gudzpoz/keypaw48/paw.png

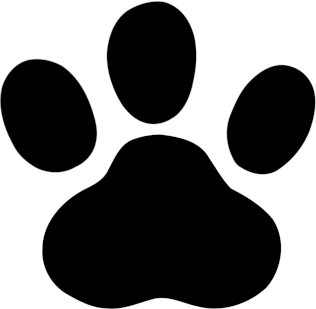
paw.png
