gudzpoz/keypaw48/keypaw48lr/keypaw48lr.kicad_pcb

## KiCad design keypaw48lr/keypaw48lr.kicad_pcb (2026-08-05)

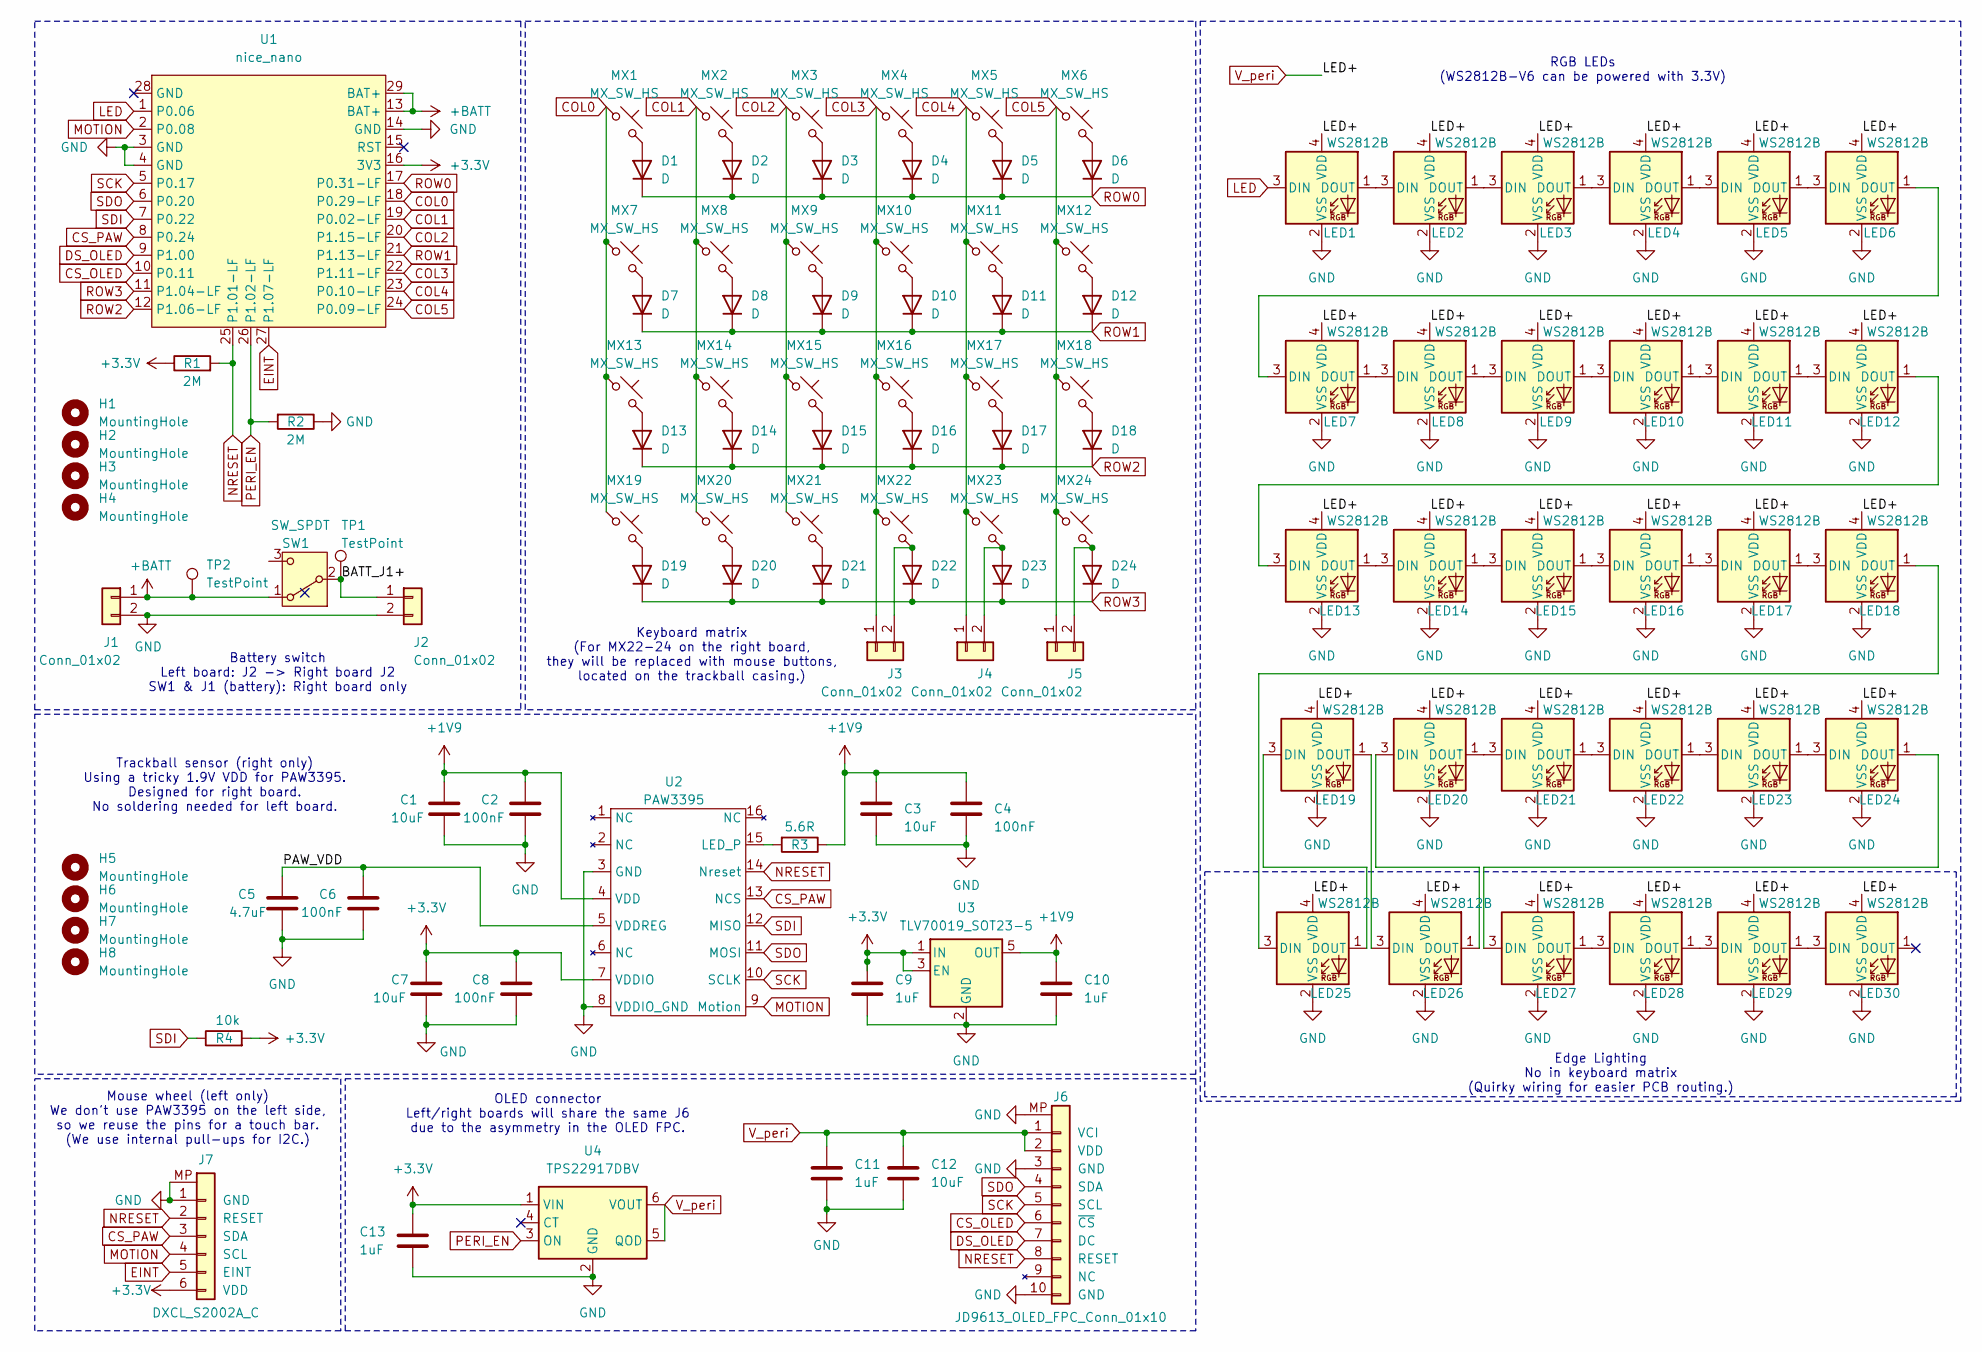
[picture p2: schematic keypaw48lr.kicad_sch, Keypaw48 Schematic (Left & Right Board)]

Parts:
C1, C3, C7, C12: 10uF; C_1206_3216Metric_Pad1.33x1.80mm_HandSolder
C2, C4, C6, C8: 100nF; C_0805_2012Metric_Pad1.18x1.45mm_HandSolder
C5: 4.7uF; C_1206_3216Metric_Pad1.33x1.80mm_HandSolder
C9, C10, C11: 1uF; C_1206_3216Metric_Pad1.33x1.80mm_HandSolder
C13: 1uF; C_1206_3216Metric_Pad1.33x1.80mm_HandSolder_REV
D1, D2, D3, D4, D5, D6, D7, D8, D9, D10, D11, D12, D13, D14, D15, D16, D17, D18, D19, D20, D21, D22, D23, D24: D; D_SOD-123_REV
H1, H2, H3, H4, H5, H6, H7, H8: MountingHole; MountingHole_2.2mm_M2_DIN965_Pad_TopBottom
J1: Conn_01x02; Conn_1x02_P1.25mm_Horizontal_Battery_REV
J2: Conn_01x02; Conn_1x02_P1.25mm_Horizontal_Battery
J3, J4, J5: Conn_01x02; Molex_PicoBlade_53048-0210_1x02_P1.25mm_Horizontal
J6: JD9613_OLED_FPC_Conn_01x10; FH34SRJ-10S-0.5SH
J7: DXCL_S2002A_C; FH34SRJ-10S-0.5SH
LED1, LED2, LED3, LED4, LED5, LED6, LED7, LED8, LED9, LED10, LED11, LED12, LED13, LED14, LED15, LED16, LED17, LED18, LED19, LED20, LED21, LED22, LED23, LED24, LED25, LED26, LED27, LED28, LED29, LED30: WS2812B; LED_WS2812B-2020_backmount_rev
MX1, MX2, MX3, MX4, MX5, MX6, MX7, MX8, MX9, MX10, MX11, MX12, MX13, MX14, MX15, MX16, MX17, MX18, MX19, MX20, MX21, MX22, MX23, MX24: MX_SW_HS; SW_MX_HS_REV
R1, R2: 2M; R_1206_3216Metric_Pad1.30x1.75mm_HandSolder
R3: 5.6R; R_1206_3216Metric_Pad1.30x1.75mm_HandSolder
R4: 10k; R_1206_3216Metric_Pad1.30x1.75mm_HandSolder
SW1: SW_SPDT; SW_SPDT_CK_JS102011SAQN
TP1, TP2: TestPoint; TestPoint_THTPad_D2.0mm_Drill1.0mm_nosilk
U1: nice_nano; nice_nano_AH_USBup_REV
U2: PAW3395
U3: TLV70019_SOT23-5; SOT-23-5_HandSoldering
U4: TPS22917DBV; SOT-23-6_Handsoldering_REV

Connections:
+1V9: C1.1, C2.1, C3.1, C4.1, C10.1, R3.1, U2.4 (VDD), U3.5 (OUT)
+3.3V: C7.1, C8.1, C9.1, C13.1, J7.6 (VDD), R1.1, R4.2, U1.16 (3V3), U2.7 (VDDIO), U3.1 (IN), U3.3 (EN), U4.1 (VIN)
+BATT: J1.1, SW1.1 (A), TP2.1 (1_1), U1.13 (BAT+), U1.29 (BAT+)
/BATT_J1+: J2.1, SW1.2 (B), TP1.1 (1_1)
/PAW_VDD: C5.1, C6.1, U2.5 (VDDREG)
COL0: MX1.1, MX7.1, MX13.1, MX19.1, U1.18 (P0.29-LF)
COL1: MX2.1, MX8.1, MX14.1, MX20.1, U1.19 (P0.02-LF)
COL2: MX3.1, MX9.1, MX15.1, MX21.1, U1.20 (P1.15-LF)
COL3: J3.1, MX4.1, MX10.1, MX16.1, MX22.1, U1.22 (P1.11-LF)
COL4: J4.1, MX5.1, MX11.1, MX17.1, MX23.1, U1.23 (P0.10-LF)
COL5: J5.1, MX6.1, MX12.1, MX18.1, MX24.1, U1.24 (P0.09-LF)
CS_OLED: J6.6 (~CS), U1.10 (P0.11)
CS_PAW: J7.3 (SDA), U1.8 (P0.24), U2.13 (NCS)
DS_OLED: J6.7 (DC), U1.9 (P1.00)
EINT: J7.5 (EINT), U1.27 (P1.07-LF)
GND: C1.2, C2.2, C3.2, C4.2, C5.2, C6.2, C7.2, C8.2, C9.2, C10.2, C11.2, C12.2, C13.2, J1.2, J2.2, J6.3 (GND), J6.10 (GND), J6.MP, J7.1 (GND), J7.MP, LED1.2 (VSS), LED2.2 (VSS), LED3.2 (VSS), LED4.2 (VSS), LED5.2 (VSS), LED6.2 (VSS), LED7.2 (VSS), LED8.2 (VSS), LED9.2 (VSS), LED10.2 (VSS), LED11.2 (VSS), LED12.2 (VSS), LED13.2 (VSS), LED14.2 (VSS), LED15.2 (VSS), LED16.2 (VSS), LED17.2 (VSS), LED18.2 (VSS), LED19.2 (VSS), LED20.2 (VSS), LED21.2 (VSS), LED22.2 (VSS), LED23.2 (VSS), LED24.2 (VSS), LED25.2 (VSS), LED26.2 (VSS), LED27.2 (VSS), LED28.2 (VSS), LED29.2 (VSS), LED30.2 (VSS), R2.1, U1.3 (GND), U1.4 (GND), U1.14 (GND), U2.3 (GND), U2.8 (VDDIO_GND), U3.2 (GND), U4.2 (GND)
LED: LED1.3 (DIN), U1.1 (P0.06)
MOTION: J7.4 (SCL), U1.2 (P0.08), U2.9 (Motion)
NRESET: J6.8 (RESET), J7.2 (RESET), R1.2, U1.25 (P1.01-LF), U2.14 (Nreset)
unnamed: D1.2 (A), MX1.2
unnamed: D2.2 (A), MX2.2
unnamed: D3.2 (A), MX3.2
unnamed: D4.2 (A), MX4.2
unnamed: D5.2 (A), MX5.2
unnamed: D6.2 (A), MX6.2
unnamed: D7.2 (A), MX7.2
unnamed: D8.2 (A), MX8.2
unnamed: D9.2 (A), MX9.2
unnamed: D10.2 (A), MX10.2
unnamed: D11.2 (A), MX11.2
unnamed: D12.2 (A), MX12.2
unnamed: D13.2 (A), MX13.2
unnamed: D14.2 (A), MX14.2
unnamed: D15.2 (A), MX15.2
unnamed: D16.2 (A), MX16.2
unnamed: D17.2 (A), MX17.2
unnamed: D18.2 (A), MX18.2
unnamed: D19.2 (A), MX19.2
unnamed: D20.2 (A), MX20.2
unnamed: D21.2 (A), MX21.2
unnamed: D22.2 (A), J3.2, MX22.2
unnamed: D23.2 (A), J4.2, MX23.2
unnamed: D24.2 (A), J5.2, MX24.2
unnamed: LED1.1 (DOUT), LED2.3 (DIN)
unnamed: LED2.1 (DOUT), LED3.3 (DIN)
unnamed: LED3.1 (DOUT), LED4.3 (DIN)
unnamed: LED4.1 (DOUT), LED5.3 (DIN)
unnamed: LED5.1 (DOUT), LED6.3 (DIN)
unnamed: LED6.1 (DOUT), LED7.3 (DIN)
unnamed: LED7.1 (DOUT), LED8.3 (DIN)
unnamed: LED8.1 (DOUT), LED9.3 (DIN)
unnamed: LED9.1 (DOUT), LED10.3 (DIN)
unnamed: LED10.1 (DOUT), LED11.3 (DIN)
unnamed: LED11.1 (DOUT), LED12.3 (DIN)
unnamed: LED12.1 (DOUT), LED13.3 (DIN)
unnamed: LED13.1 (DOUT), LED14.3 (DIN)
unnamed: LED14.1 (DOUT), LED15.3 (DIN)
unnamed: LED15.1 (DOUT), LED16.3 (DIN)
unnamed: LED16.1 (DOUT), LED17.3 (DIN)
unnamed: LED17.1 (DOUT), LED18.3 (DIN)
unnamed: LED18.1 (DOUT), LED25.3 (DIN)
unnamed: LED19.3 (DIN), LED25.1 (DOUT)
unnamed: LED19.1 (DOUT), LED26.3 (DIN)
unnamed: LED20.3 (DIN), LED26.1 (DOUT)
unnamed: LED20.1 (DOUT), LED21.3 (DIN)
unnamed: LED21.1 (DOUT), LED22.3 (DIN)
unnamed: LED22.1 (DOUT), LED23.3 (DIN)
unnamed: LED23.1 (DOUT), LED24.3 (DIN)
unnamed: LED24.1 (DOUT), LED27.3 (DIN)
unnamed: LED27.1 (DOUT), LED28.3 (DIN)
unnamed: LED28.1 (DOUT), LED29.3 (DIN)
unnamed: LED29.1 (DOUT), LED30.3 (DIN)
unnamed: R3.2, U2.15 (LED_P)
PERI_EN: R2.2, U1.26 (P1.02-LF), U4.3 (ON)
ROW0: D1.1 (K), D2.1 (K), D3.1 (K), D4.1 (K), D5.1 (K), D6.1 (K), U1.17 (P0.31-LF)
ROW1: D7.1 (K), D8.1 (K), D9.1 (K), D10.1 (K), D11.1 (K), D12.1 (K), U1.21 (P1.13-LF)
ROW2: D13.1 (K), D14.1 (K), D15.1 (K), D16.1 (K), D17.1 (K), D18.1 (K), U1.12 (P1.06-LF)
ROW3: D19.1 (K), D20.1 (K), D21.1 (K), D22.1 (K), D23.1 (K), D24.1 (K), U1.11 (P1.04-LF)
SCK: J6.5 (SCL), U1.5 (P0.17), U2.10 (SCLK)
SDI: R4.1, U1.7 (P0.22), U2.12 (MISO)
SDO: J6.4 (SDA), U1.6 (P0.20), U2.11 (MOSI)
V_peri: C11.1, C12.1, J6.1 (VCI), J6.2 (VDD), LED1.4 (VDD), LED2.4 (VDD), LED3.4 (VDD), LED4.4 (VDD), LED5.4 (VDD), LED6.4 (VDD), LED7.4 (VDD), LED8.4 (VDD), LED9.4 (VDD), LED10.4 (VDD), LED11.4 (VDD), LED12.4 (VDD), LED13.4 (VDD), LED14.4 (VDD), LED15.4 (VDD), LED16.4 (VDD), LED17.4 (VDD), LED18.4 (VDD), LED19.4 (VDD), LED20.4 (VDD), LED21.4 (VDD), LED22.4 (VDD), LED23.4 (VDD), LED24.4 (VDD), LED25.4 (VDD), LED26.4 (VDD), LED27.4 (VDD), LED28.4 (VDD), LED29.4 (VDD), LED30.4 (VDD), U4.5 (QOD), U4.6 (VOUT)

Notes on the sheet:
Trackball sensor (right only) Using a tricky 1.9V VDD for PAW3395. Designed for right board. No soldering needed for left board.
Battery switch Left board: J2 -> Right board J2 SW1 & J1 (battery): Right board only
Mouse wheel (left only) We don't use PAW3395 on the left side, so we reuse the pins for a touch bar. (We use internal pull-ups for I2C.)
Edge Lighting No in keyboard matrix (Quirky wiring for easier PCB routing.)
OLED connector Left/right boards will share the same J6 due to the asymmetry in the OLED FPC.
Keyboard matrix (For MX22-24 on the right board, they will be replaced with mouse buttons, located on the trackball casing.)
RGB LEDs (WS2812B-V6 can be powered with 3.3V)

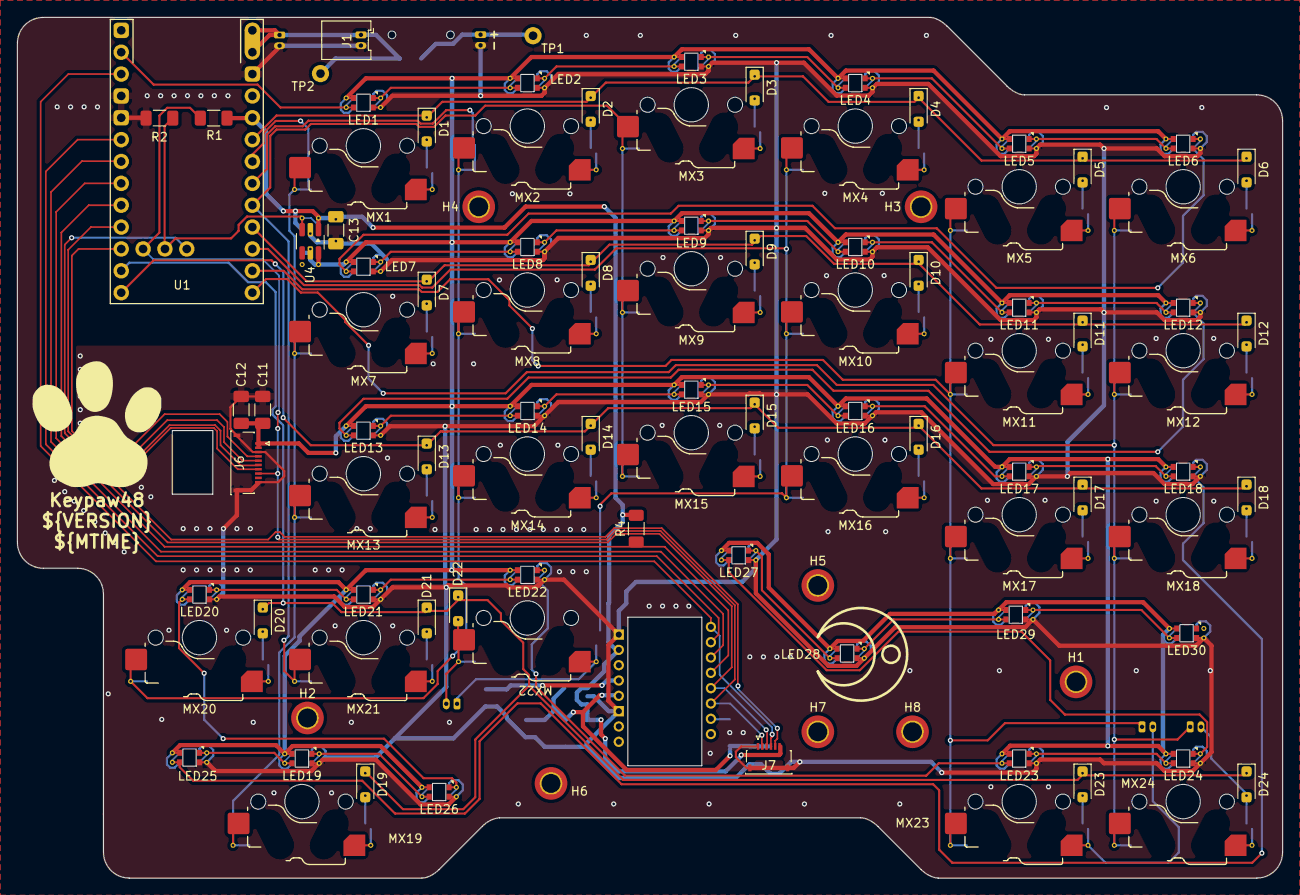
[picture p3: board keypaw48lr.kicad_pcb from above]

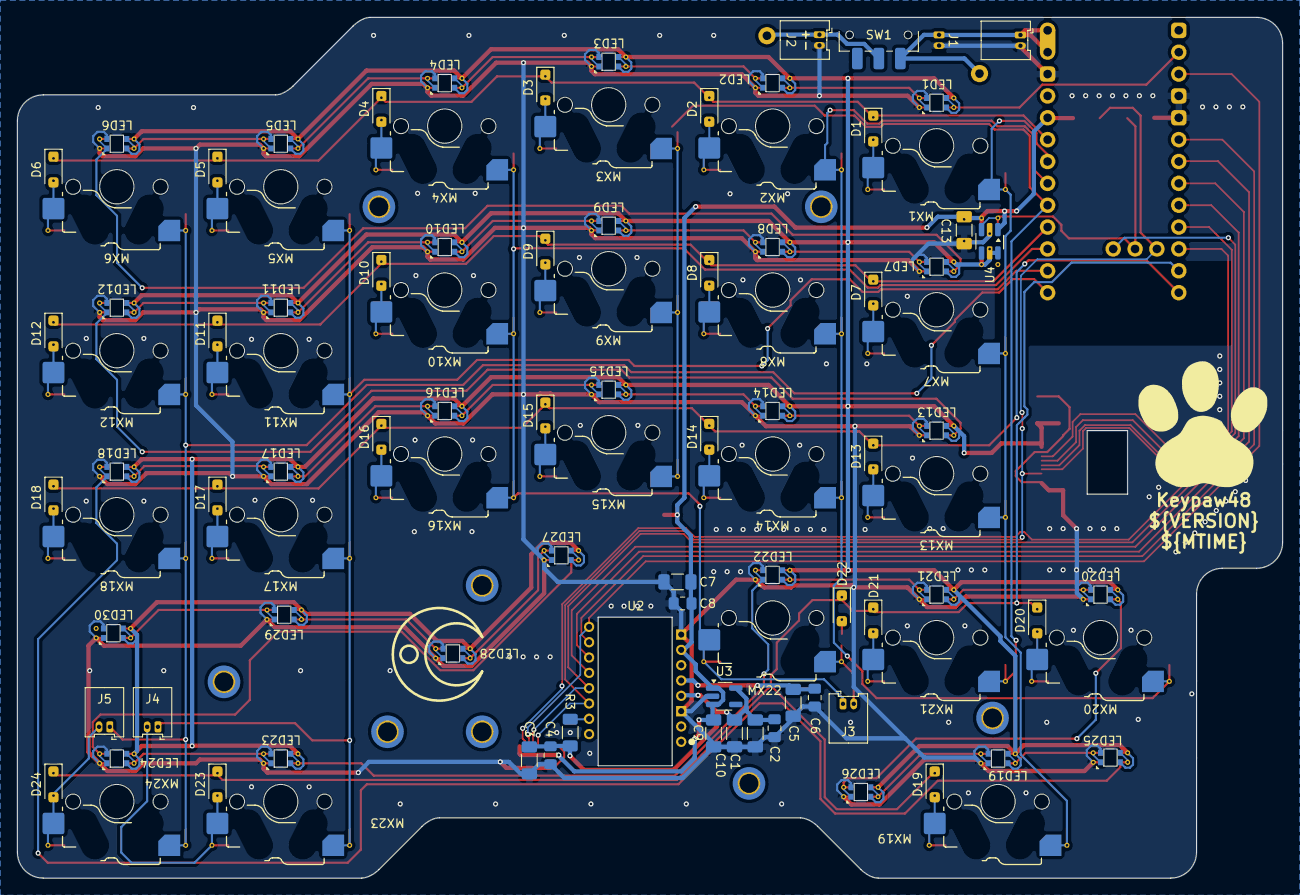
[picture p4: board keypaw48lr.kicad_pcb from below]

Board: 2 copper layers, 147.0 x 100.0 mm, 117 parts (21 on the bottom side), 82 nets.
