gudzpoz/keypaw48/(commit log)

2026-07-29 chore: init kicad repo
    [keypaw48lr.kicad_pcb, keypaw48lr.kicad_sch]
2026-07-29 chore: set up jlc requirements
    [keypaw48lr.kicad_pcb]
2026-07-29 feat: add leds and paw3395 to schema
    [keypaw48lr.kicad_sch]
2026-07-30 feat: complete basic schematic design
    [keypaw48lr.kicad_pcb, keypaw48lr.kicad_sch]
2026-07-30 feat: add B.SilkS printing for diode
2026-07-30 feat: add symbol/footprint for OLED screen
    [keypaw48lr.kicad_sch]
2026-07-30 fix: drc errors in footprints
    - D_SOD-323_HandSoldering_REV: reversible diode, through holes in SMD
    - SW_MX_HS_REV: overlapping NPTH, use oval instead
    - LED_WS2812B-2020_backmount_rev: B.Silkscreen clearance
2026-07-31 feat: group leds with rule areas for multichannel wiring
    [keypaw48lr.kicad_sch]
2026-07-31 feat: layout key matrix with kbplacer
    [keypaw48lr.kicad_pcb]
2026-07-31 feat: multichannel wiring the leds
    [keypaw48lr.kicad_pcb]
2026-07-31 feat: basic key matrix wiring
    [keypaw48lr.kicad_pcb, keypaw48lr.kicad_sch]
2026-07-31 feat: finish pcb wiring draft
    [keypaw48lr.kicad_pcb, keypaw48lr.kicad_sch]
2026-07-31 fix: should be able to solder nice!nano on both sides
    [keypaw48lr.kicad_pcb, keypaw48lr.kicad_sch]
2026-07-31 feat: add some more led lights
    [keypaw48lr.kicad_pcb, keypaw48lr.kicad_sch]
2026-08-01 feat: replace encoder with a touch bar
    [keypaw48lr.kicad_pcb, keypaw48lr.kicad_sch]
2026-08-01 feat: modify pcb for a simple box casing
    [keypaw48lr.kicad_pcb, keypaw48lr.kicad_sch]
2026-08-01 fix: route spi tracks out of antenna keepout zone
    [keypaw48lr.kicad_pcb]
2026-08-01 fix: reversible +BATT connector for left board
    [keypaw48lr.kicad_pcb, keypaw48lr.kicad_sch]
2026-08-01 chore: add a logo
    [keypaw48lr.kicad_pcb]
2026-08-05 fix: move oled fpc out of antenna range?
    [keypaw48lr.kicad_pcb, keypaw48lr.kicad_sch]
2026-08-05 fix: non-reverse-mountable V_peri components
    [keypaw48lr.kicad_pcb, keypaw48lr.kicad_sch]
